nipo/UsbGpib/HW/VQFN/Fabrication_files/bom.xls

Comment | Designator | Footprint | JLCPCB Part #
22R | R3,R2 | R0603 | C23345
ATMEGA32U4-MU | U1 | VQFN-44_EP_7.0x7.0x0.5P | C45874
22pF | C5,C6 | C0603 | C1653
100K | R5 | R0604 | C25803
4uF | C1 | C0805 | C1779
16mhzcrystal20pf | Y1 | SMD-3225_4P | C164049
2K2 | R1 | R0604 | C4190
470R | R4 | R0604 | C23179
0.1uF | C2,C3,C4 | C0603 | C14663
1uF | C7 | C0604 | C15849
redLED | D1 | D0805 | C84256
