nipo/UsbGpib/HW/VQFN_Type-C/Release/A/UsbGpibTypeC_A.pdf

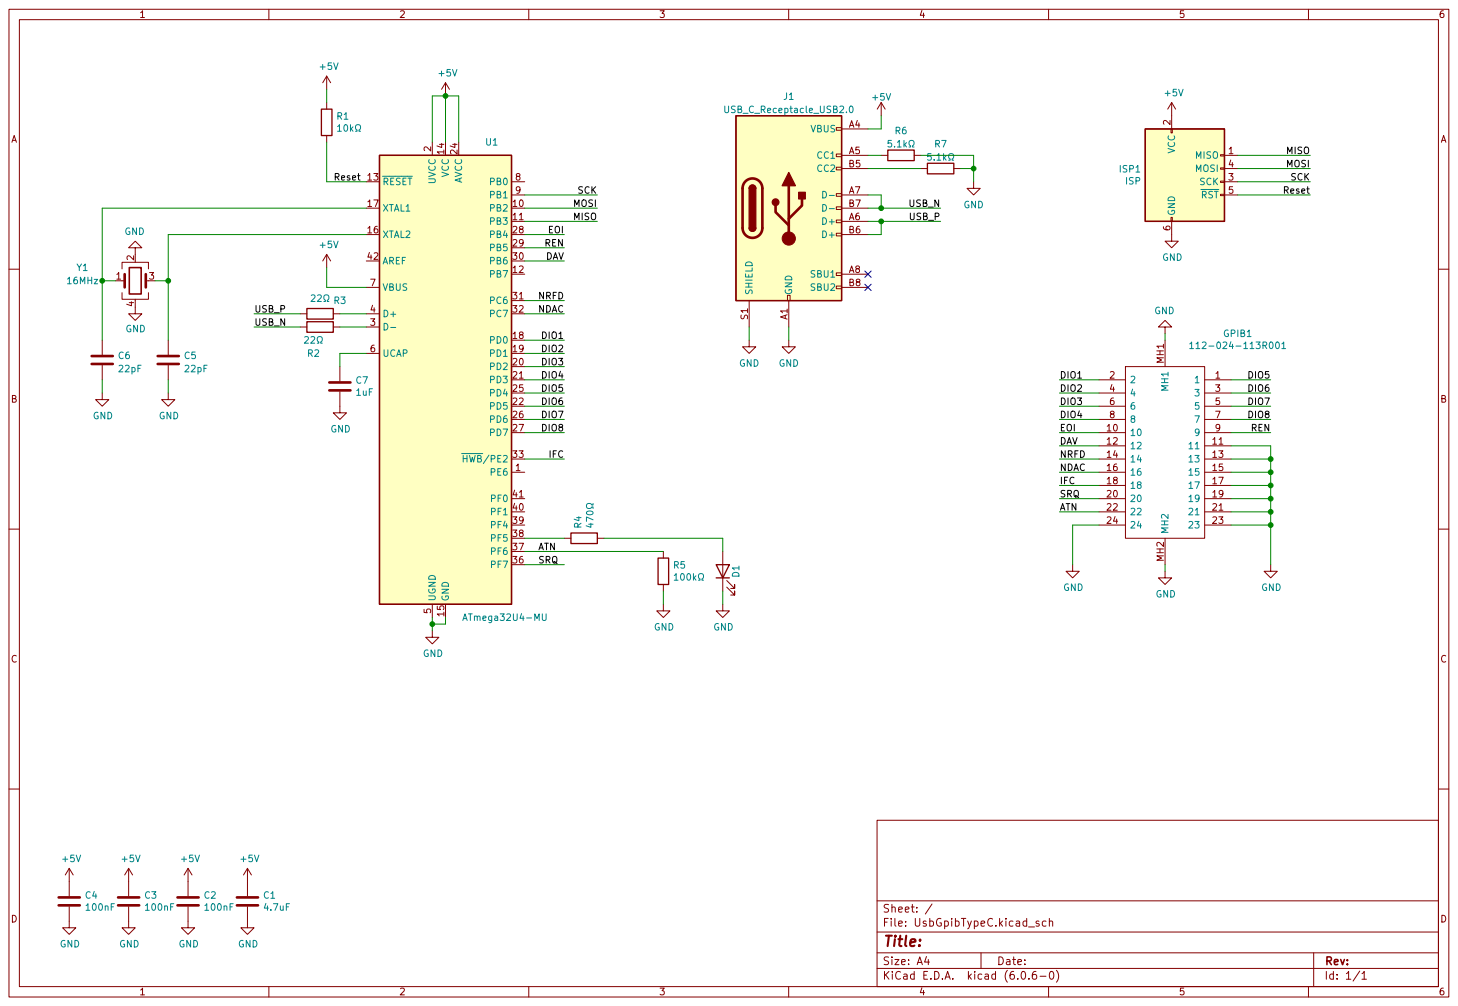
[picture p4: page 1]

2 SCK 3 MOSI 4 ~{RST} 5 GND

2 PD2 20 PD3 21 PD5 22 AVCC 24 PD4 25 PD6 26 PD7 27 PB4 28 PB5 29 D- 3 PB6 30 PC6 31 PC7 32 ~{HWB}/PE233 PF7 36 PF6 37 PF5 38 PF4 39 D+ 4 PF1 40 PF0 41 AREF 42 UGND

File: UsbGpibTypeC.kicad_sch Sheet: / GND
