nipo/UsbGpib/HW/VQFN_Type-C/Project/UsbGpibTypeC.kicad_pcb

## KiCad design HW/VQFN_Type-C/Project/UsbGpibTypeC.kicad_pcb (2023-01-11)

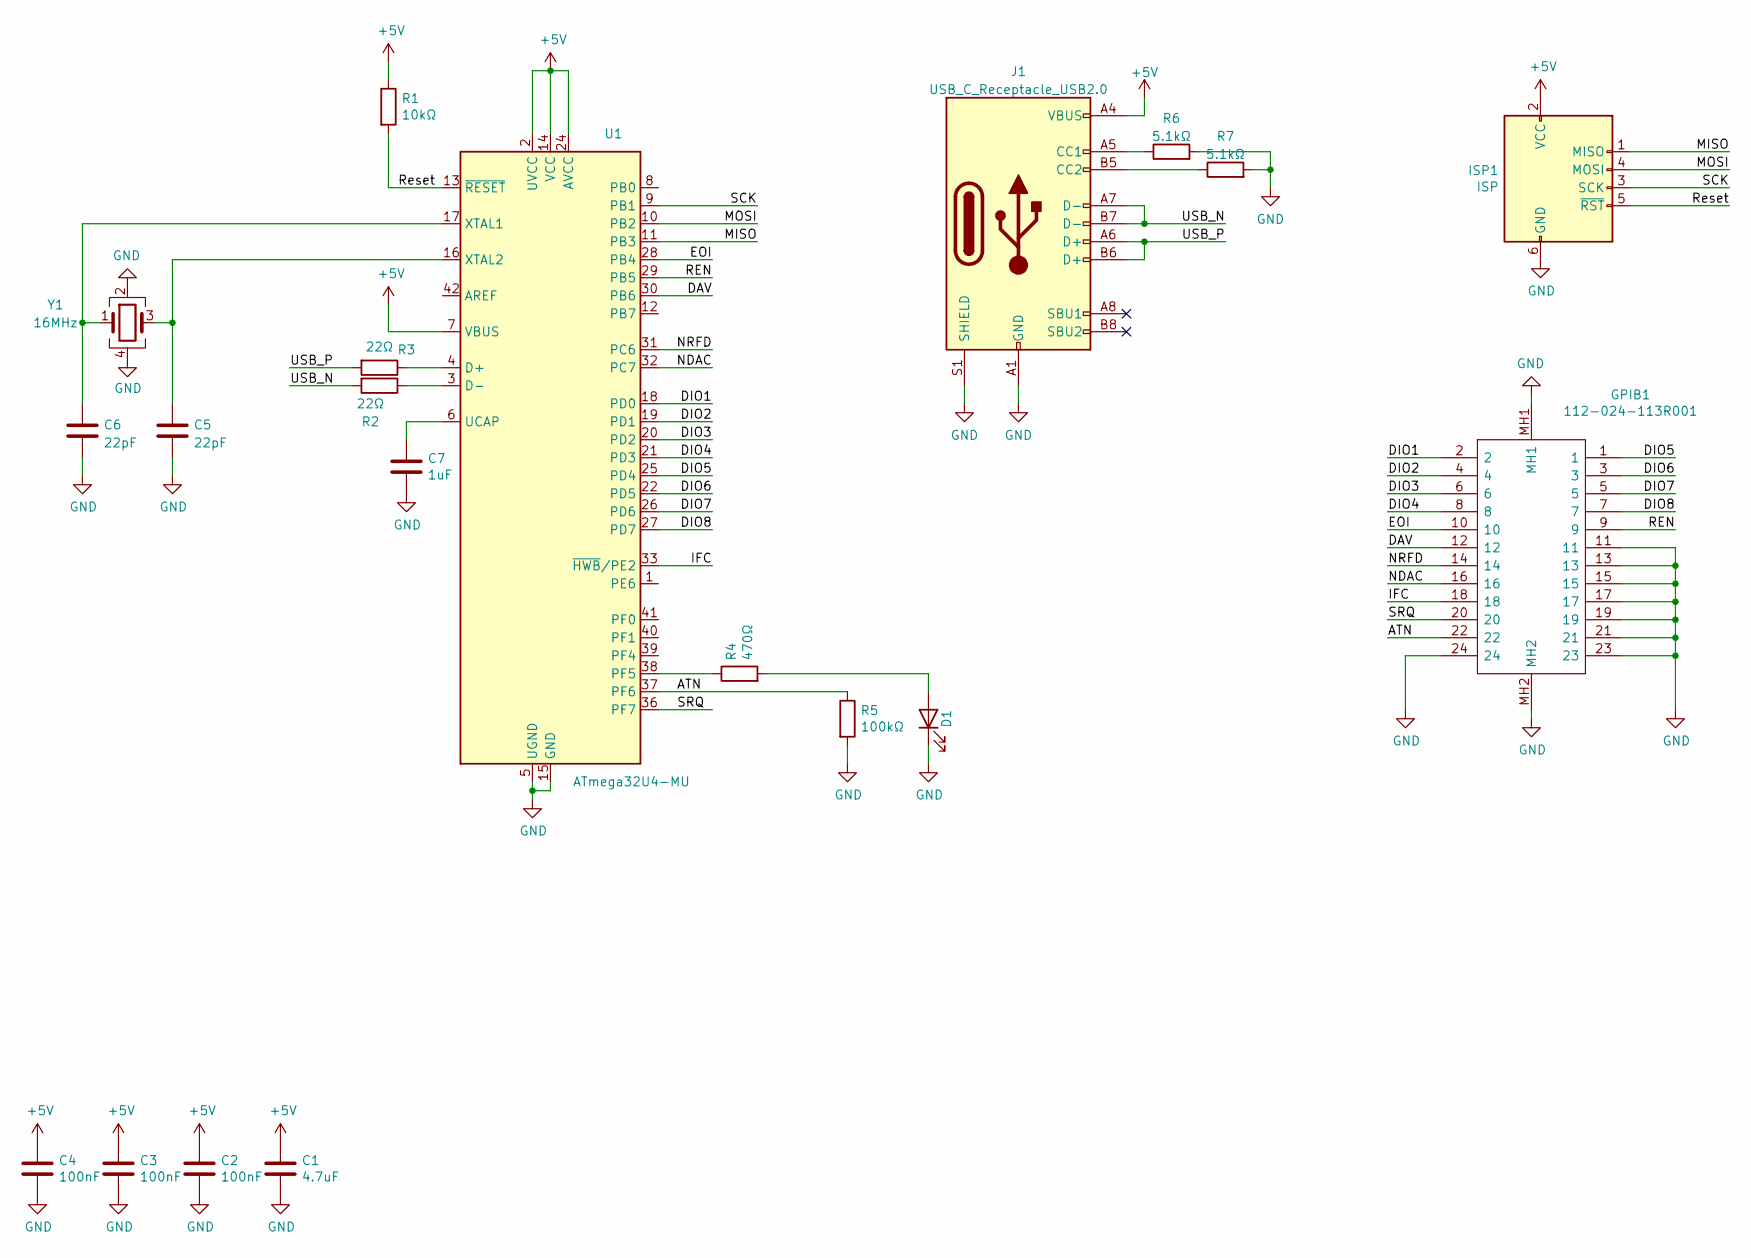
[picture p5: schematic UsbGpibTypeC.kicad_sch, UsbGpib Type C]

Parts:
C1: 4.7uF; C_0603_1608Metric; LCSC C19666
C2, C3, C4: 100nF; C_0402_1005Metric; LCSC C1525
C5, C6: 22pF; C_0402_1005Metric; LCSC C1555
C7: 1uF; C_0603_1608Metric; LCSC C15849
D1: Red; LED_0603_1608Metric; LCSC C965799
GPIB1: 112-024-113R001; 112024113R001; MPN 112-024-113R001; Digi-Key 1024RMA-ND
ISP1: ISP; PinHeader_2x03_P2.54mm_Vertical
J1: USB_C_Receptacle_USB2.0; CX90M-16P; MPN CX90M-16P; Digi-Key CX90M-16P
R1: 10kΩ; R_0402_1005Metric; LCSC C25744
R2, R3: 22Ω; R_0402_1005Metric; LCSC C25092
R4: 470Ω; R_0402_1005Metric; LCSC C25117
R5: 100kΩ; R_0402_1005Metric; LCSC C25741
R6, R7: 5.1kΩ; R_0402_1005Metric; LCSC C25905
U1: ATmega32U4-MU; QFN-44-1EP_7x7mm_P0.5mm_EP5.2x5.2mm; MPN ATMEGA32U4-MU; Digi-Key ATMEGA32U4-MU-ND
Y1: 16MHz; Crystal_SMD_3225-4Pin_3.2x2.5mm; LCSC C13738

Connections:
+5V: C1.1, C2.1, C3.1, C4.1, ISP1.2 (VCC), J1.A4 (VBUS), J1.A9 (VBUS), J1.B4 (VBUS), J1.B9 (VBUS), R1.1, U1.2 (UVCC), U1.7 (VBUS), U1.14 (VCC), U1.24 (AVCC), U1.34 (VCC), U1.44 (AVCC)
/ATN: GPIB1.22, R5.1, U1.37 (PF6)
/DAV: GPIB1.12, U1.30 (PB6)
/DIO1: GPIB1.2, U1.18 (PD0)
/DIO2: GPIB1.4, U1.19 (PD1)
/DIO3: GPIB1.6, U1.20 (PD2)
/DIO4: GPIB1.8, U1.21 (PD3)
/DIO5: GPIB1.1, U1.25 (PD4)
/DIO6: GPIB1.3, U1.22 (PD5)
/DIO7: GPIB1.5, U1.26 (PD6)
/DIO8: GPIB1.7, U1.27 (PD7)
/EOI: GPIB1.10, U1.28 (PB4)
/IFC: GPIB1.18, U1.33 (~HWB/PE2)
/MISO: ISP1.1 (MISO), U1.11 (PB3)
/MOSI: ISP1.4 (MOSI), U1.10 (PB2)
/NDAC: GPIB1.16, U1.32 (PC7)
/NRFD: GPIB1.14, U1.31 (PC6)
/REN: GPIB1.9, U1.29 (PB5)
/Reset: ISP1.5 (~RST), R1.2, U1.13 (~RESET)
/SCK: ISP1.3 (SCK), U1.9 (PB1)
/SRQ: GPIB1.20, U1.36 (PF7)
/USB_N: J1.A7 (D-), J1.B7 (D-), R2.2
/USB_P: J1.A6 (D+), J1.B6 (D+), R3.2
GND: C1.2, C2.2, C3.2, C4.2, C5.2, C6.2, C7.2, D1.1 (K), GPIB1.11, GPIB1.13, GPIB1.15, GPIB1.17, GPIB1.19, GPIB1.21, GPIB1.23, GPIB1.24, GPIB1.MH1, GPIB1.MH2, ISP1.6 (GND), J1.A1 (GND), J1.A12 (GND), J1.B1 (GND), J1.B12 (GND), J1.S1 (SHIELD), R5.2, R6.2, R7.2, U1.5 (UGND), U1.15 (GND), U1.23 (GND), U1.35 (GND), U1.43 (GND), U1.45 (GND), Y1.2, Y1.4
unnamed: C5.1, U1.16 (XTAL2), Y1.3
unnamed: C6.1, U1.17 (XTAL1), Y1.1
unnamed: C7.1, U1.6 (UCAP)
unnamed: D1.2 (A), R4.2
unnamed: J1.A5 (CC1), R6.1
unnamed: J1.B5 (CC2), R7.1
unnamed: R2.1, U1.3 (D-)
unnamed: R3.1, U1.4 (D+)
unnamed: R4.1, U1.38 (PF5)

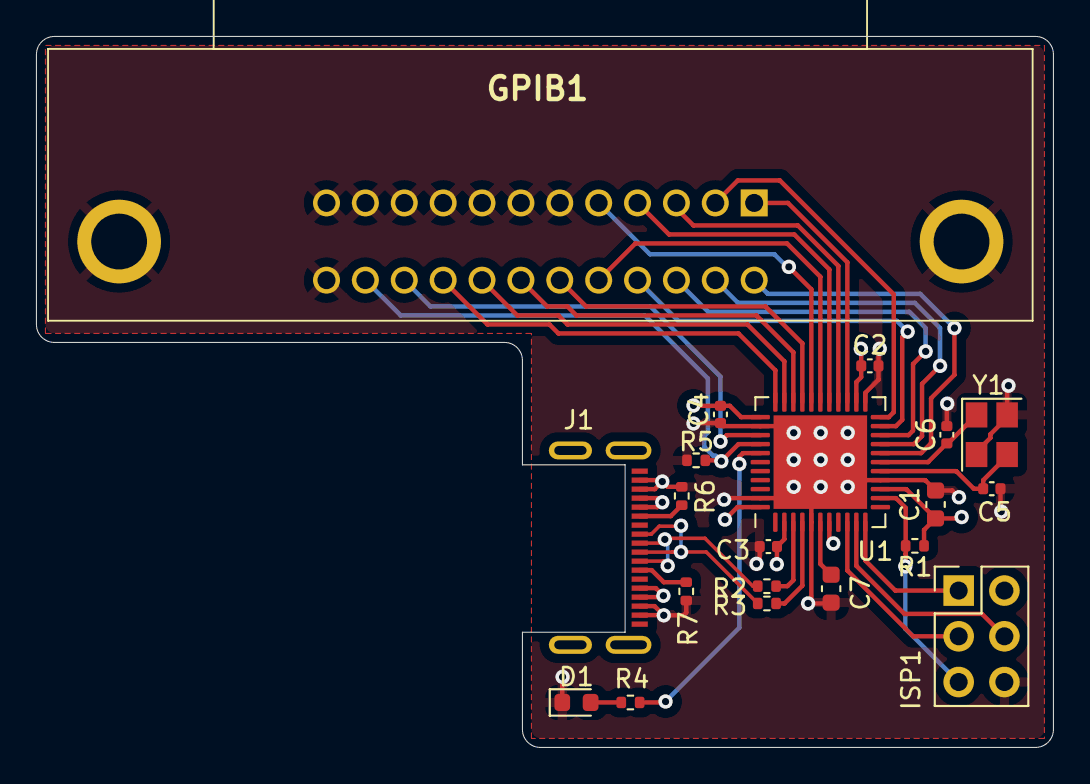
[picture p6: board UsbGpibTypeC.kicad_pcb from above]

Board: 4 copper layers, 56.5 x 39.5 mm, 20 parts (0 on the bottom side), 33 nets.
