nipo/UsbGpib/HW/V1/USBGpib.brd

## EAGLE design HW/V1/USBGpib.brd (2023-01-10, an earlier design)

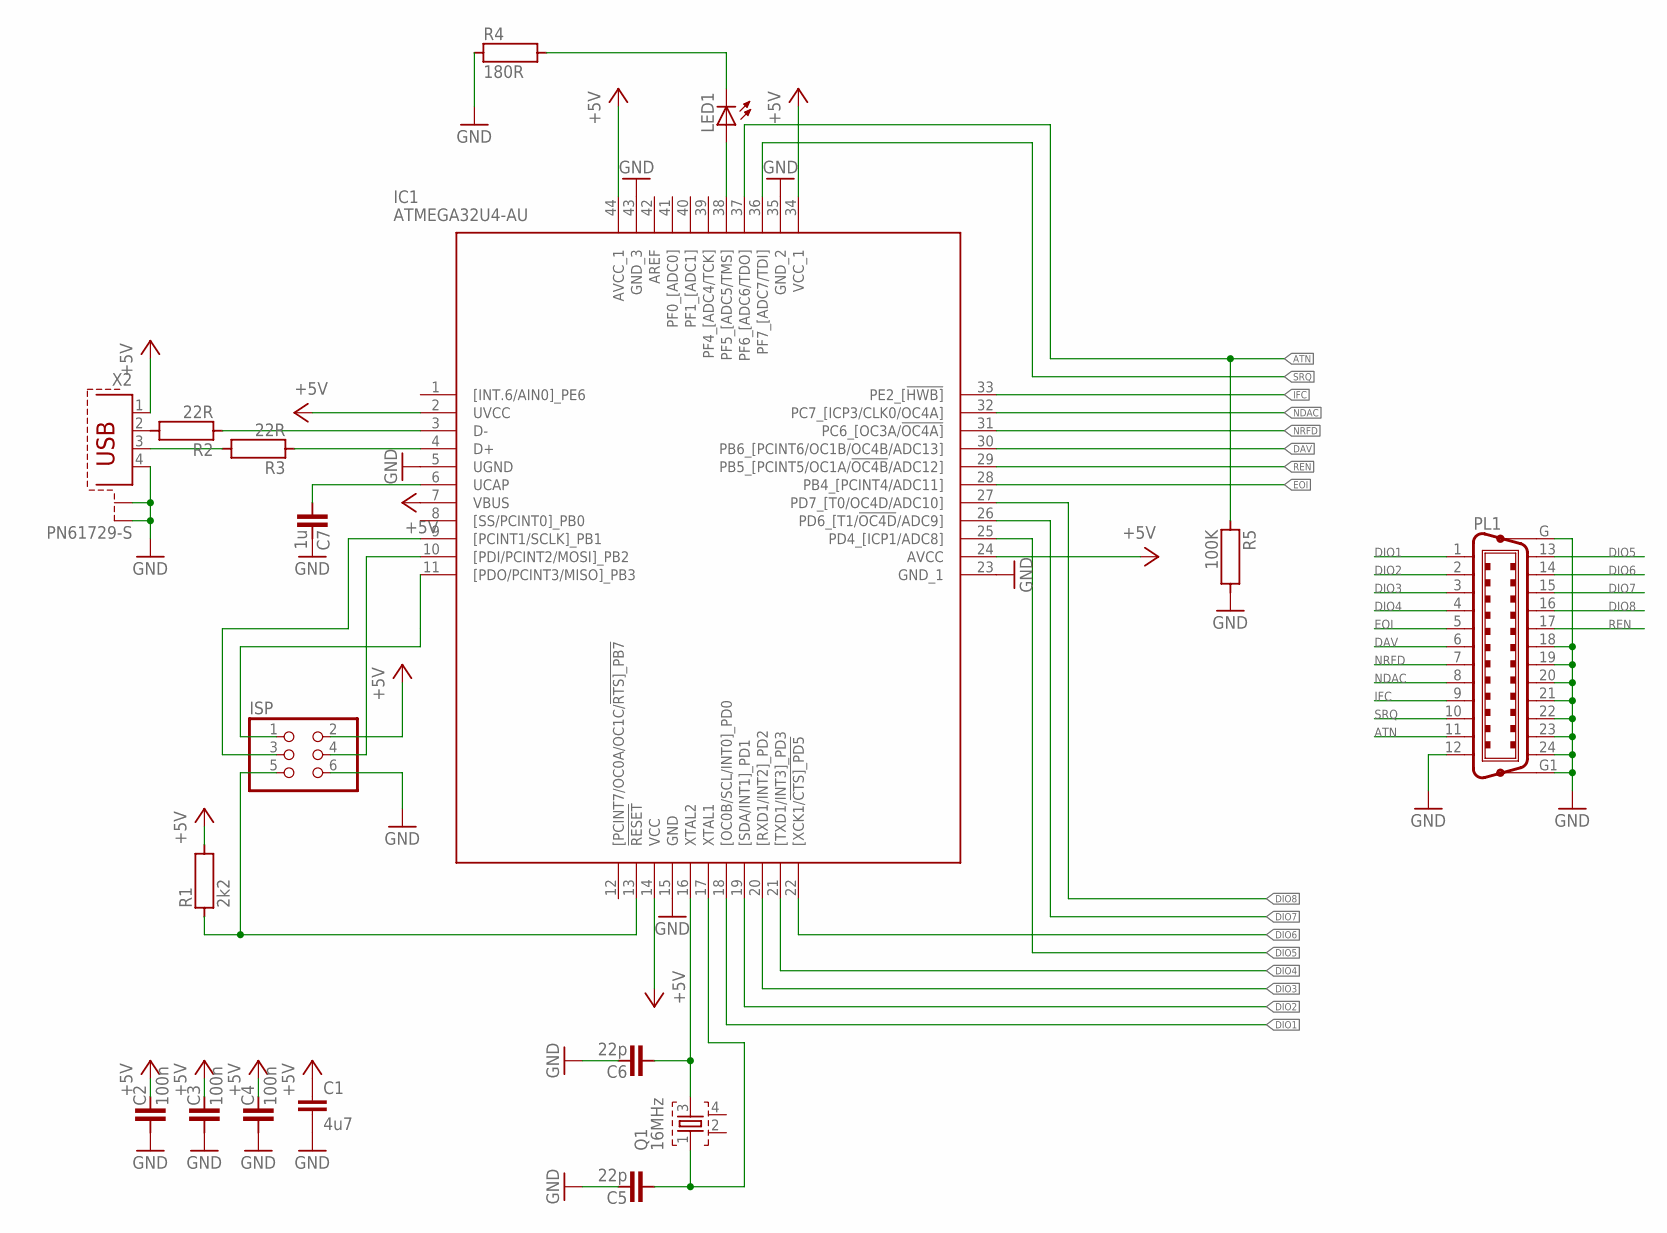
[picture p7: schematic USBGpib.sch]

Parts:
C1: 4u7; C1210
C2, C3, C4: 100n; C0402
C5, C6: 22p; C0402
C7: 1u; C0603
IC1: ATMEGA32U4-AU; QFP80P1200X1200X120-44N
ISP: PINHD-2X3; 2X03
LED1: LEDCHIPLED_1206; CHIPLED_1206
PL1: C24HPMALE; 24HP_MALE
Q1: 16MHz; FA-20H
R1: 2k2; R0402
R2, R3: 22R; R0402
R4: 180R; R0402
R5: 100K; R0402
X2: PN61729-S

Connections:
+5V: C1.1, C2.2, C3.2, C4.2, IC1.2 (UVCC), IC1.7 (VBUS), IC1.14 (VCC), IC1.24 (AVCC), IC1.34 (VCC_1), IC1.44 (AVCC_1), ISP.2, R1.2, X2.1
ATN: IC1.37 (PF6_[ADC6/TDO]), PL1.11, R5.1
DAV: IC1.30 (PB6_[PCINT6/OC1B/OC4B/ADC13]), PL1.6
DIO1: IC1.18 ([OC0B/SCL/INT0]_PD0), PL1.1
DIO2: IC1.19 ([SDA/INT1]_PD1), PL1.2
DIO3: IC1.20 ([RXD1/INT2]_PD2), PL1.3
DIO4: IC1.21 ([TXD1/INT3]_PD3), PL1.4
DIO5: IC1.25 (PD4_[ICP1/ADC8]), PL1.13
DIO6: IC1.22 ([XCK1/!CTS]_PD5), PL1.14
DIO7: IC1.26 (PD6_[T1/!OC4D!/ADC9]), PL1.15
DIO8: IC1.27 (PD7_[T0/OC4D/ADC10]), PL1.16
EOI: IC1.28 (PB4_[PCINT4/ADC11]), PL1.5
GND: C1.2, C2.1, C3.1, C4.1, C5.2, C6.2, C7.2, IC1.5 (UGND), IC1.15 (GND), IC1.23 (GND_1), IC1.35 (GND_2), IC1.43 (GND_3), ISP.6, PL1.12, PL1.18, PL1.19, PL1.20, PL1.21, PL1.22, PL1.23, PL1.24, PL1.G, PL1.G1, R4.1, R5.2, X2.4, X2.S1, X2.S2
IFC: IC1.33 (PE2_[!HWB]), PL1.9
unnamed: C6.1, IC1.16 (XTAL2), Q1.3
unnamed: C5.1, IC1.17 (XTAL1), Q1.1
unnamed: C7.1, IC1.6 (UCAP)
unnamed: R2.2, X2.2
unnamed: IC1.3 (D-), R2.1
unnamed: IC1.4 (D+), R3.1
unnamed: R3.2, X2.3
unnamed: IC1.13 (!RESET), ISP.5, R1.1
unnamed: LED1.C, R4.2
unnamed: IC1.10 ([PDI/PCINT2/MOSI]_PB2), ISP.4
unnamed: IC1.9 ([PCINT1/SCLK]_PB1), ISP.3
unnamed: IC1.11 ([PDO/PCINT3/MISO]_PB3), ISP.1
unnamed: IC1.38 (PF5_[ADC5/TMS]), LED1.A
NDAC: IC1.32 (PC7_[ICP3/CLK0/OC4A]), PL1.8
NRFD: IC1.31 (PC6_[OC3A/!OC4A]), PL1.7
REN: IC1.29 (PB5_[PCINT5/OC1A/!OC4B!/ADC12]), PL1.17
SRQ: IC1.36 (PF7_[ADC7/TDI]), PL1.10

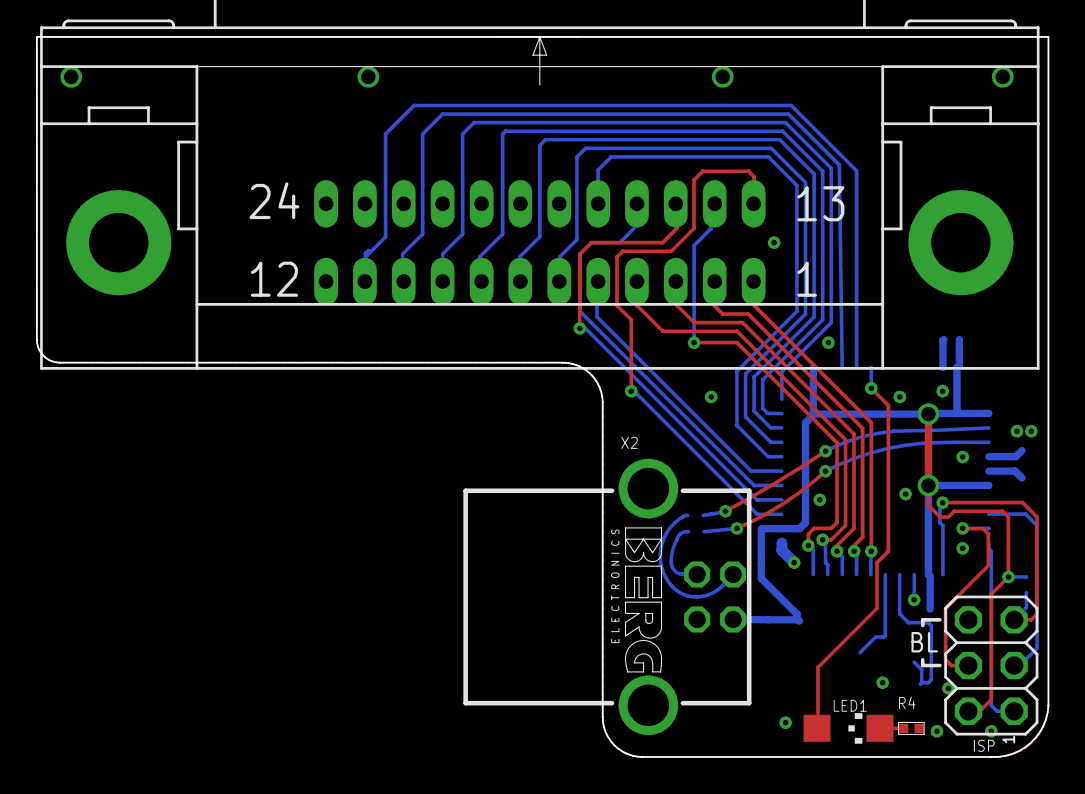
[picture p8: board USBGpib.brd from above]

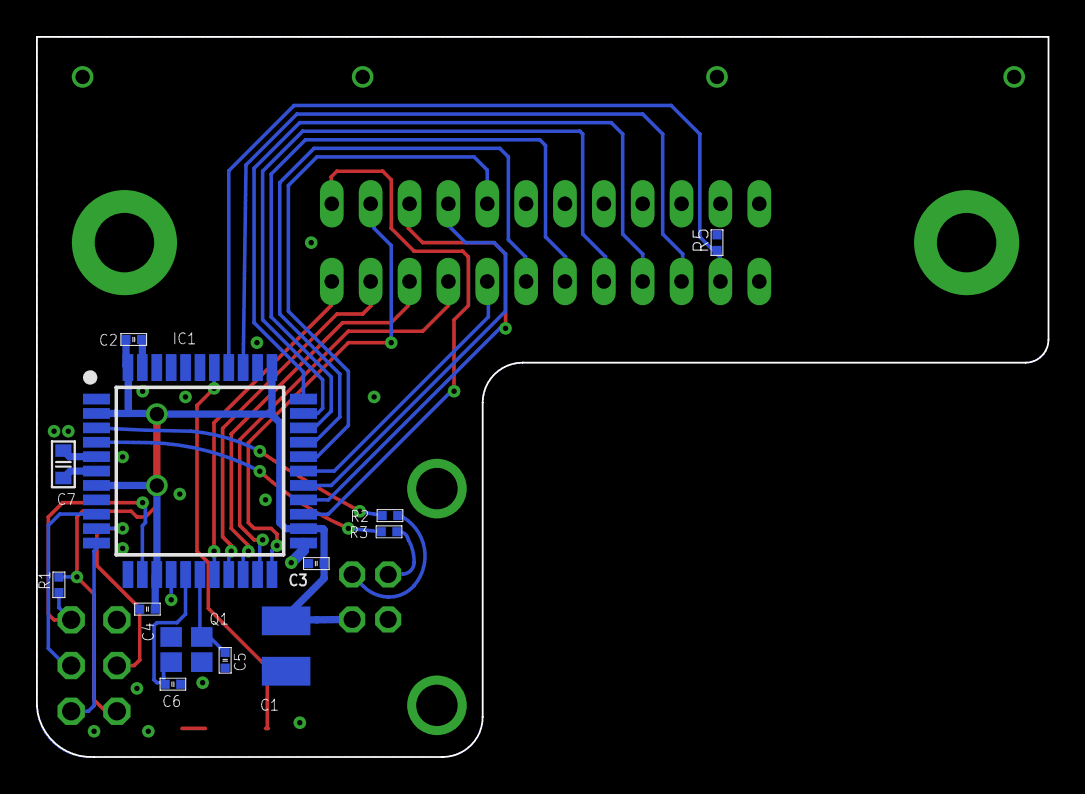
[picture p9: board USBGpib.brd from below]

Board: 2 copper layers, 56.2 x 40.0 mm, 18 parts (13 on the bottom side), 31 nets.
