nipo/UsbGpib/(commit log)

2023-01-10 SW/TestAndMeasurement: Scan addresses from high values first
    The scan is taking the first address that responds, but then looks
    for lower matching address (masked with 0x1f) if >= 0x20. If we scan
    from low addresses first, we can never get to this case.
2023-01-10 HW: Move versions around
    [USBGpib.brd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]
2023-01-11 HW: Add Type-C version
    [UsbGpibTypeC.kicad_pcb, UsbGpibTypeC.kicad_sch, UsbGpibTypeC_A_BOM.csv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]
2023-01-11 SW/TestAndMeasurement: Fix control request parsing
    Setup packet's bmRequestType Type and Recipient fields are enumerated,
    they were trated as bitfields.
    [TestAndMeasurement.c]
2023-01-11 SW/TestAndMeasurement: Also try legacy 'ID' command for SN gathering
    This is used by pre-GPIB devices like HP5385A (HP-IB).
2023-01-28 Add mounted board images
